tggr-lab/incubator-co2-monitor/docs/img/raw/graph.png

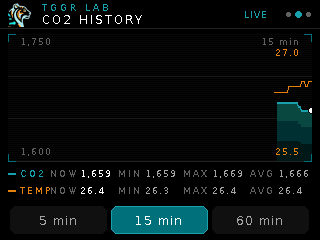
docs/img/raw/graph.png
