tggr-lab/incubator-co2-monitor/docs/img/raw/main.png

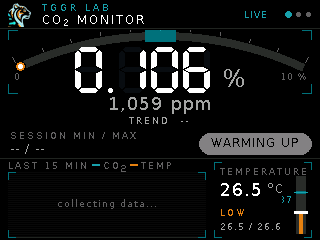
docs/img/raw/main.png
