tggr-lab/incubator-co2-monitor/firmware/CO2_CYD/Logo.h

#pragma once
//
// LOGO artwork -- GENERATED FILE, do not hand-edit.
//
//   regenerate:  tools/png2logo.py <your.png> -o Logo.h
//
// Source image : assets/tggr_lab_logo.png
// Size         : 26x26, RGB565, row-major
// Flattened on : #000000
//
// Pixels equal to LOGO_TRANSPARENT are skipped by the drawing code, so a
// logo with a cut-out can sit on top of a coloured surface.
//
#include <Arduino.h>

constexpr int16_t  LOGO_WIDTH  = 26;
constexpr int16_t  LOGO_HEIGHT = 26;
constexpr uint16_t LOGO_TRANSPARENT = 0xF81F;

// 676 pixels, 1352 bytes, kept in flash.
const uint16_t LOGO_DATA[676] PROGMEM = {
    0x0000, 0x0000, 0x0000, 0x0000, 0x0000, 0x0000, 0x0000, 0x0000, 0x0000, 0x0020, 0x0000, 0x0000,
    0x0000, 0x0000, 0x0000, 0x0000, 0x0000, 0x0000, 0x0000, 0x0000, 0x0000, 0x0000, 0x0000, 0x0000,
    0x0000, 0x0000, 0x0000, 0x0000, 0x0000, 0x0000, 0x0000, 0x0000, 0x0000, 0x0000, 0x0000, 0x0000,
    0x0000, 0x0000, 0x0000, 0x0000, 0x0000, 0x0000, 0x0000, 0x0000, 0x0000, 0x0000, 0x0000, 0x0000,
    0x0000, 0x0000, 0x0000, 0x0000, 0x0000, 0x0000, 0x0000, 0x0000, 0x0000, 0x0000, 0x0882, 0x29E8,
    0x3A49, 0x6C30, 0x0000, 0x0000, 0x0020, 0x0000, 0x0000, 0x0000, 0x0000, 0x0000, 0x0000, 0x0000,
    0x0000, 0x0000, 0x0000, 0x0000, 0x0000, 0x0000, 0x0000, 0x0000, 0x0000, 0x0000, 0x0000, 0x2986,
    0x95D7, 0x8CD2, 0x96BB, 0xA73D, 0x6410, 0x0000, 0x0000, 0x0000, 0x0000, 0x0000, 0x0000, 0x0000,
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
    0xAF7C, 0x7CF4, 0x3A69, 0x6C71, 0x95D7, 0x95F7, 0x84F4, 0x0841, 0x0000, 0x0000, 0x0000, 0x0000,
    0x0000, 0x2430, 0x2D34, 0x33AE, 0x0020, 0x0000, 0x0020, 0x8DB6, 0xA79E, 0xAF7D, 0x532C, 0x0000,
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
};
