tggr-lab/incubator-co2-monitor/firmware/CO2_CYD/LogoBoot.h

#pragma once
//
// LOGO_BOOT artwork -- GENERATED FILE, do not hand-edit.
//
//   regenerate:  tools/png2logo.py <your.png> -o LogoBoot.h
//
// Source image : assets/tggr_lab_logo.png
// Size         : 100x100, RGB565, row-major
// Flattened on : #000000
//
// Pixels equal to LOGO_TRANSPARENT are skipped by the drawing code, so a
// logo with a cut-out can sit on top of a coloured surface.
//
#include <Arduino.h>

constexpr int16_t  LOGO_BOOT_WIDTH  = 100;
constexpr int16_t  LOGO_BOOT_HEIGHT = 100;
constexpr uint16_t LOGO_BOOT_TRANSPARENT = 0xF81F;

// 10000 pixels, 20000 bytes, kept in flash.
const uint16_t LOGO_BOOT_DATA[10000] PROGMEM = {
    0x0000, 0x0000, 0x0000, 0x0000, 0x0000, 0x0000, 0x0000, 0x0000, 0x0000, 0x0000, 0x0000, 0x0000,
    0x0000, 0x0000, 0x0000, 0x0000, 0x0000, 0x0000, 0x0000, 0x0000, 0x0000, 0x0000, 0x0000, 0x0000,
    0x0000, 0x0000, 0x0000, 0x0000, 0x0000, 0x0000, 0x0000, 0x0000, 0x0000, 0x0000, 0x0000, 0x0000,
    0x0000, 0x0000, 0x0000, 0x0000, 0x0000, 0x0000, 0x0841, 0x8C71, 0x2104, 0x0000, 0x0000, 0x0000,
    0x0000, 0x0000, 0x0841, 0x4A69, 0x4A69, 0x5AEB, 0x0861, 0x0000, 0x0000, 0x0000, 0x0000, 0x0000,
    0x0000, 0x0000, 0x0000, 0x0000, 0x0000, 0x0000, 0x0000, 0x0000, 0x0000, 0x0000, 0x0000, 0x0000,
    0x0000, 0x0000, 0x0000, 0x0000, 0x0000, 0x0000, 0x0000, 0x0000, 0x0000, 0x0000, 0x0000, 0x0000,
    0x0000, 0x0000, 0x0000, 0x0000, 0x0000, 0x0000, 0x0000, 0x0000, 0x0000, 0x0000, 0x0000, 0x0000,
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
    0x2104, 0x9CF3, 0x0020, 0x0861, 0x0000, 0x0000, 0x2124, 0xA514, 0x630C, 0x5AEB, 0x0000, 0x0000,
    0x0000, 0x0000, 0x0000, 0x0000, 0x0000, 0x0000, 0x0000, 0x0000, 0x0000, 0x0000, 0x0000, 0x0000,
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
};
