tggr-lab/incubator-co2-monitor/(commit log)

2026-09-28 DIY cell culture CO2 monitor: firmware 0.11.0, build guide and tools
    An ESP32 display board, a Winsen MH-Z16 read over PWM and a DS18B20
    probe. Includes the Arduino sketch, an illustrated build guide with a
    wiring map, charts from real incubator logs, and the tools that
    generate them.
    The firmware ships uncorrected. Calibrate against a known incubator or
    a trusted meter before relying on it.
    Claude-Session: https://claude.ai/code/session_01NPRcTsAr3j4HLgU96CZLnK
    [incubator-hour.csv, long-run-hourly.csv]
2026-09-28 Add open source licences, sharper photos and a guide-first README
    - MIT for firmware and tools, CC BY 4.0 for guide, photos and data
    - Lead photo re-exported from the sharp original at 1600 px
    - In-place photo replaced with a sharp shot, captioned as pre-calibration
    - README opens on the build guide and shows the wiring map
    - Guide page gains a licence footer; docs/.nojekyll for GitHub Pages
    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
    [make_build_guide.py]
2026-09-28 Make the guide page a complete standalone document
    The page was written for a viewer that supplied the document wrapper and
    drew the flowcharts. Served from GitHub Pages it had neither, so the three
    flowcharts showed as plain text and phones got no viewport setting.
    - Wrap docs/index.html in a full HTML document with charset and viewport
    - Load mermaid 11.4.1 to draw the flowcharts, at natural size
    - Stack the flowcharts one per row so their text stays readable
    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
